MarcinWojewodzic/C7_weatherstation/README.md

# C7_weatherstation
Simple weather station with e-inc display with measurement memory based on PMS3003 and BME688 sensors
