MarcinWojewodzic/C7_weatherstation/Hardware/C7W1B1V1.0/KiCad/3D/W25N512GVEIG.stp

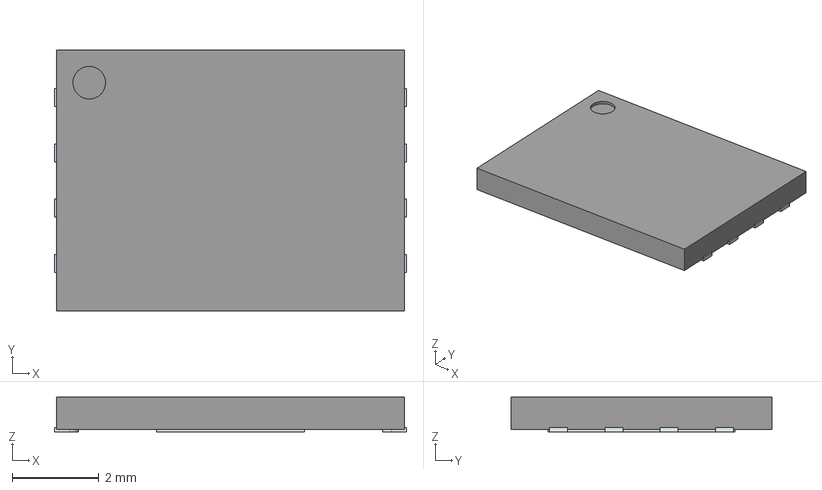
[picture p1: CAD file, 2024-11-15]
Hardware/C7W1B1V1.0/KiCad/3D/W25N512GVEIG.stp
8.10 x 6.00 x 0.8 mm
ThermalPin
PinsArrayLR
