MarcinWojewodzic/C7_weatherstation/Hardware/C7W1B1V1.0/KiCad/3D/MB85RS512TPNF-G-JNERE1.stp

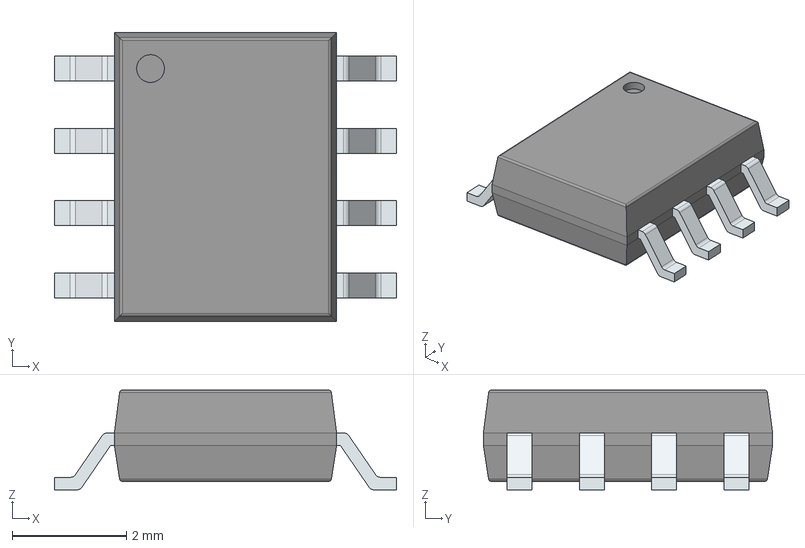
[picture p2: CAD file, 2024-11-15]
Hardware/C7W1B1V1.0/KiCad/3D/MB85RS512TPNF-G-JNERE1.stp
6.00 x 5.08 x 1.75 mm
PinsArrayLR
