MarcinWojewodzic/C7_weatherstation/Hardware/C7W1B1V1.0/KiCad/3D/STC4054GR.stp

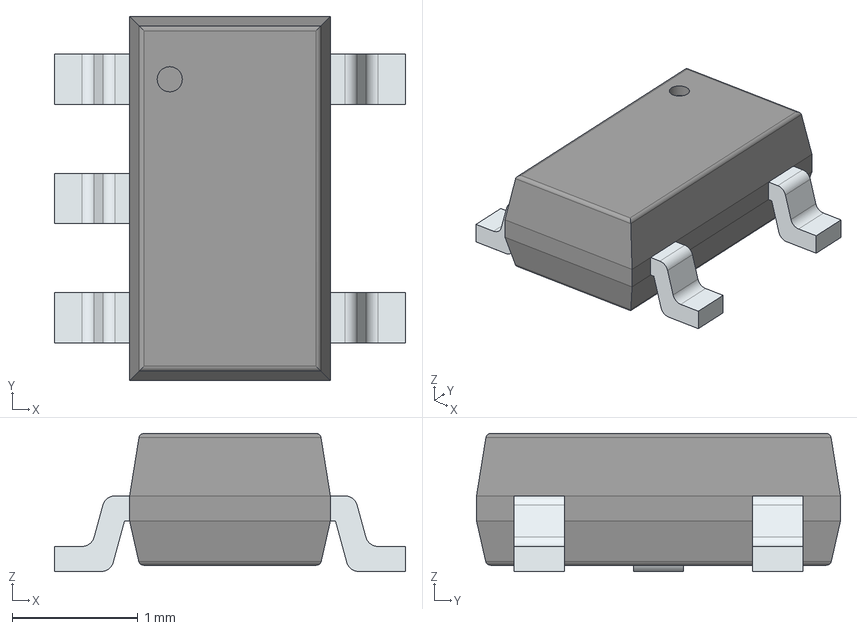
[picture p3: CAD file, 2024-11-08]
Hardware/C7W1B1V1.0/KiCad/3D/STC4054GR.stp
2.80 x 2.90 x 1.10 mm
PinsArrayL
PinsArrayR
