MarcinWojewodzic/C7_weatherstation/Hardware/C7W1B1V1.0/KiCad/3D/S-8261AAXMD-G2XT2U.stp

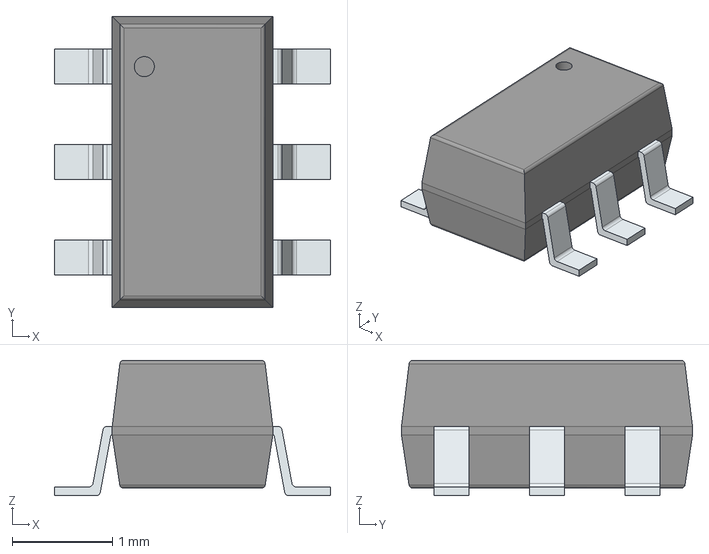
[picture p4: CAD file, 2024-11-08]
Hardware/C7W1B1V1.0/KiCad/3D/S-8261AAXMD-G2XT2U.stp
2.75 x 2.90 x 1.35 mm
PinsArrayLR
