MarcinWojewodzic/C7_weatherstation/Hardware/C7W1B1V1.0/KiCad/3D/PMDPB30XNAX.stp

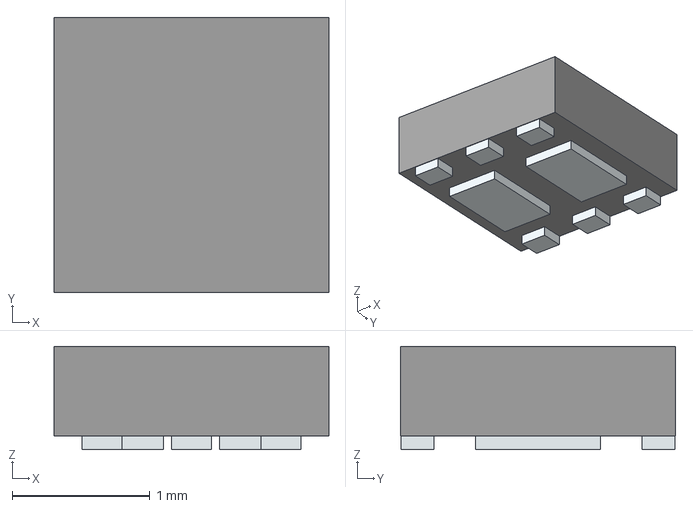
[picture p5: CAD file, 2024-11-08]
Hardware/C7W1B1V1.0/KiCad/3D/PMDPB30XNAX.stp
2.00 x 2.00 x 0.75 mm
Pins
