MarcinWojewodzic/C7_weatherstation/Hardware/C7W1B1V1.0/KiCad/3D/USBLC6-2P6.stp

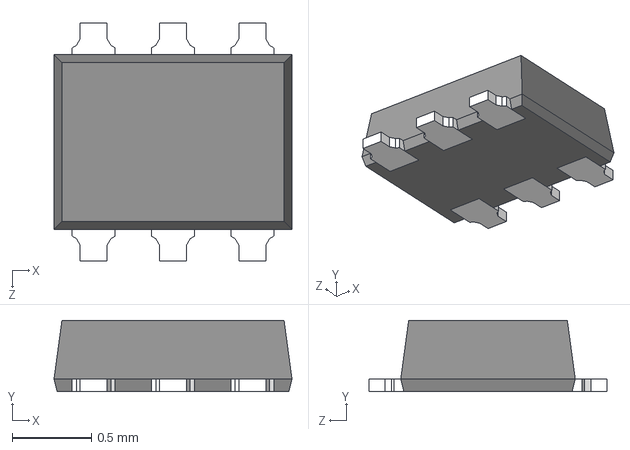
[picture p6: CAD file, 2024-11-08]
Hardware/C7W1B1V1.0/KiCad/3D/USBLC6-2P6.stp
1.50 x 0.45 x 1.50 mm
