MarcinWojewodzic/C7_weatherstation/Hardware/C7W1B1V1.0/KiCad/3D/BME688.stp

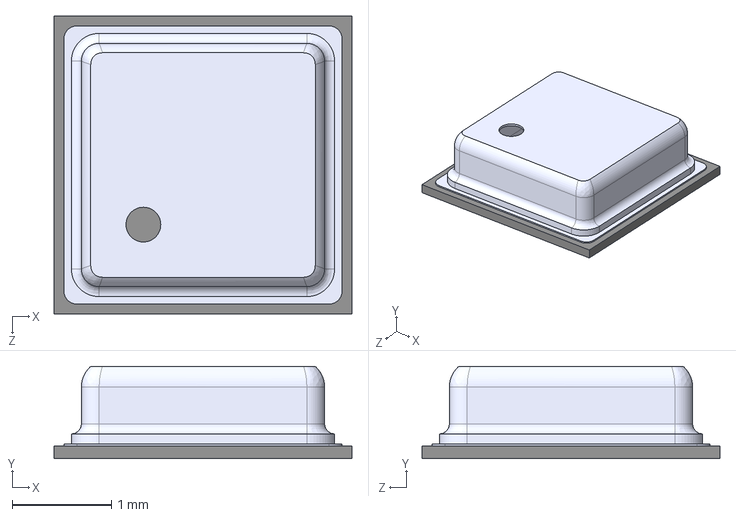
[picture p7: CAD file, 2024-11-08]
Hardware/C7W1B1V1.0/KiCad/3D/BME688.stp
3.00 x 0.93 x 3.00 mm
