MarcinWojewodzic/C7_weatherstation/Hardware/C7W1B1V1.0/KiCad/3D/USB4105GFA120.step

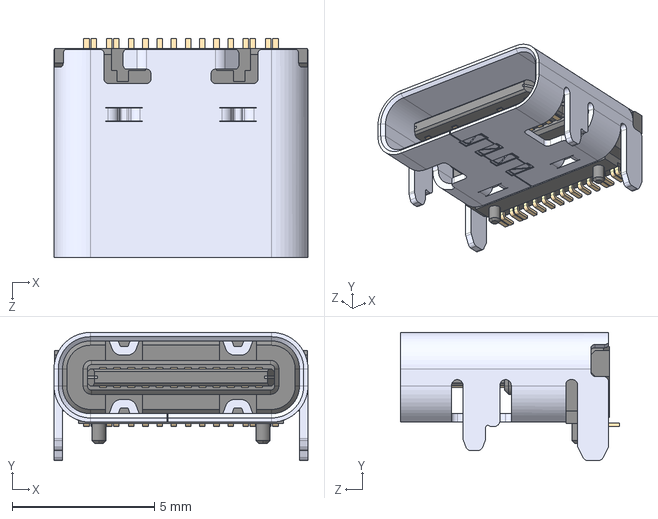
[picture p8: CAD file, 2024-11-08]
Hardware/C7W1B1V1.0/KiCad/3D/USB4105GFA120.step
8.94 x 4.51 x 7.71 mm
