MarcinWojewodzic/C7_weatherstation/Hardware/C7W1B1V1.0/KiCad/3D/LD39200PU33R.stp

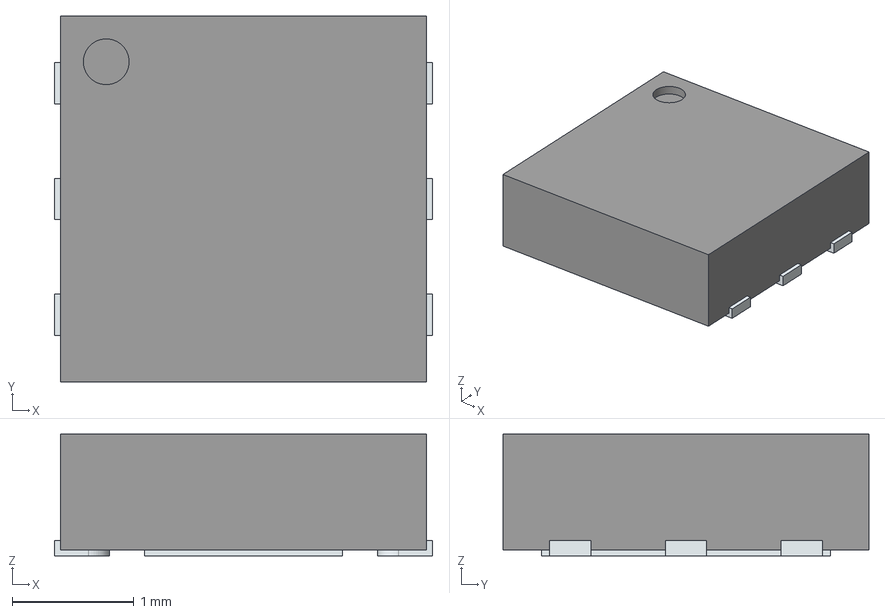
[picture p9: CAD file, 2024-11-16]
Hardware/C7W1B1V1.0/KiCad/3D/LD39200PU33R.stp
3.10 x 3.00 x 1.00 mm
ThermalPin
PinsArrayLR
