MarcinWojewodzic/C7_weatherstation/Hardware/C7W1B1V1.0/KiCad/3D/LMR62421XSD_NOPB.stp

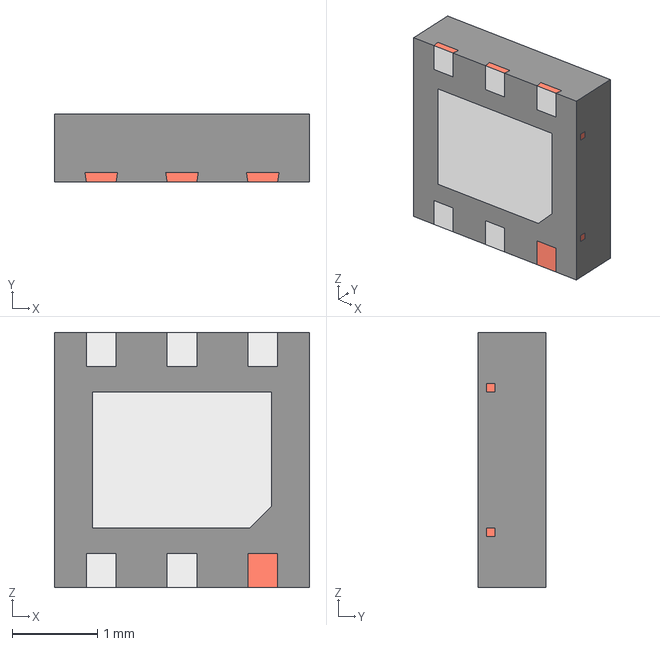
[picture p10: CAD file, 2024-11-08]
Hardware/C7W1B1V1.0/KiCad/3D/LMR62421XSD_NOPB.stp
3.00 x 0.8 x 3.00 mm
BODY_SDE06A
FRAME_SDE06A
