MarcinWojewodzic/C7_weatherstation/Hardware/C7W1B1V1.0/KiCad/C7W1B1V1.0.kicad_pcb

## KiCad design Hardware/C7W1B1V1.0/KiCad/C7W1B1V1.0.kicad_pcb (2024-11-16)

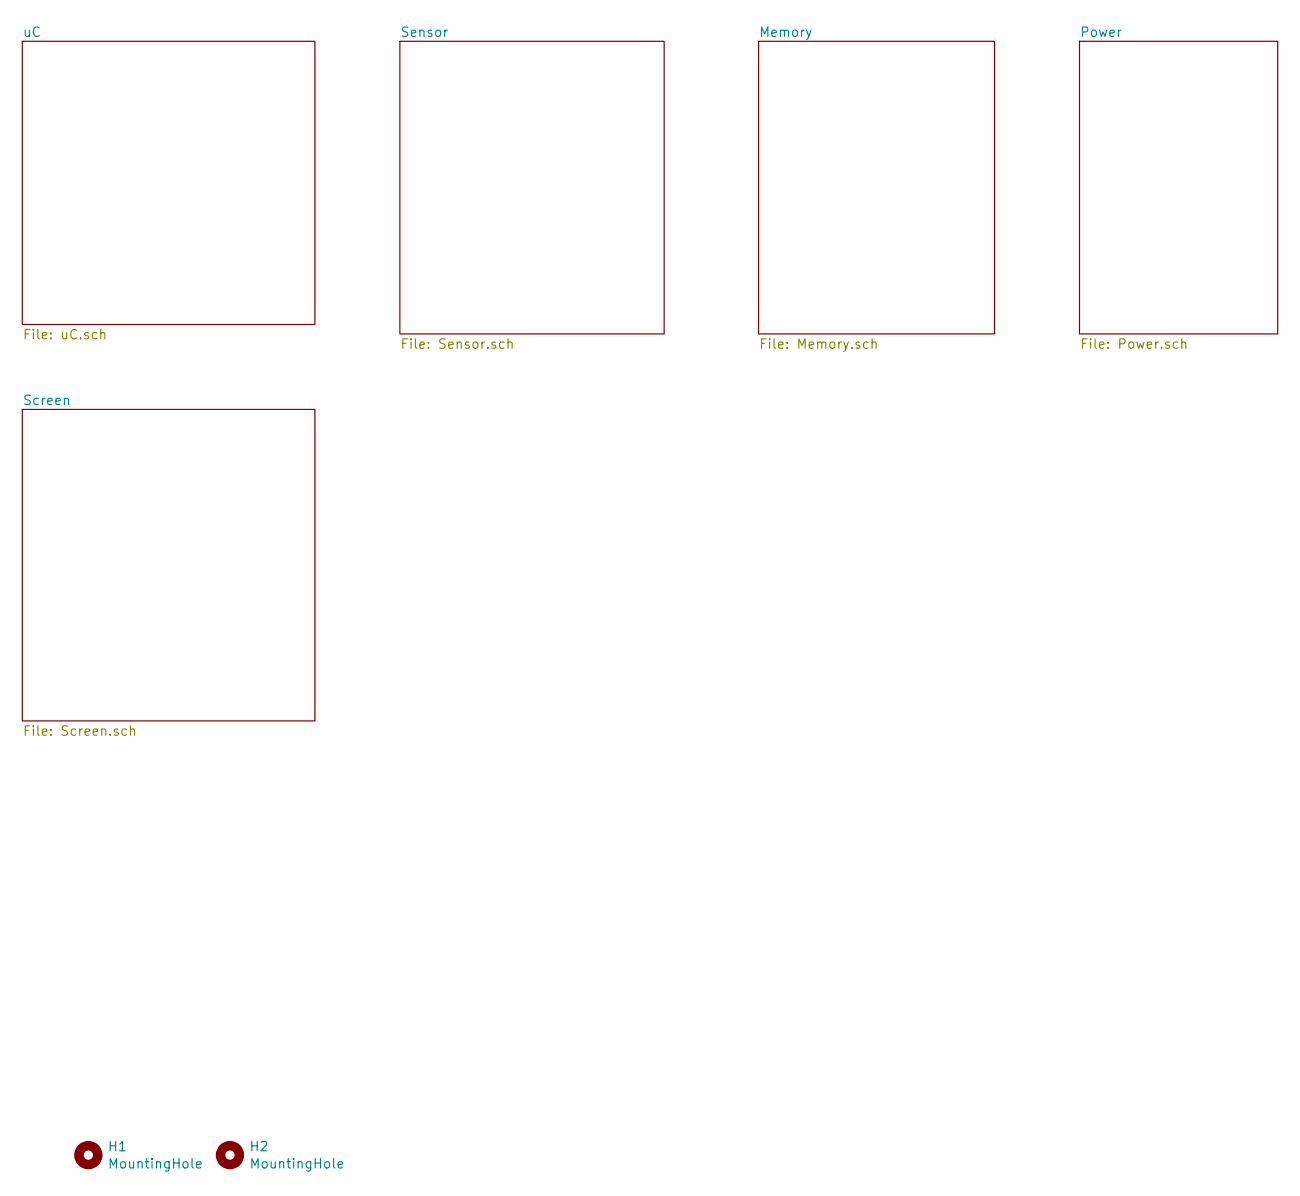
[picture p11: schematic C7W1B1V1.0.sch]

Parts:
H1, H2: MountingHole; MountingHole_2.7mm_M2.5

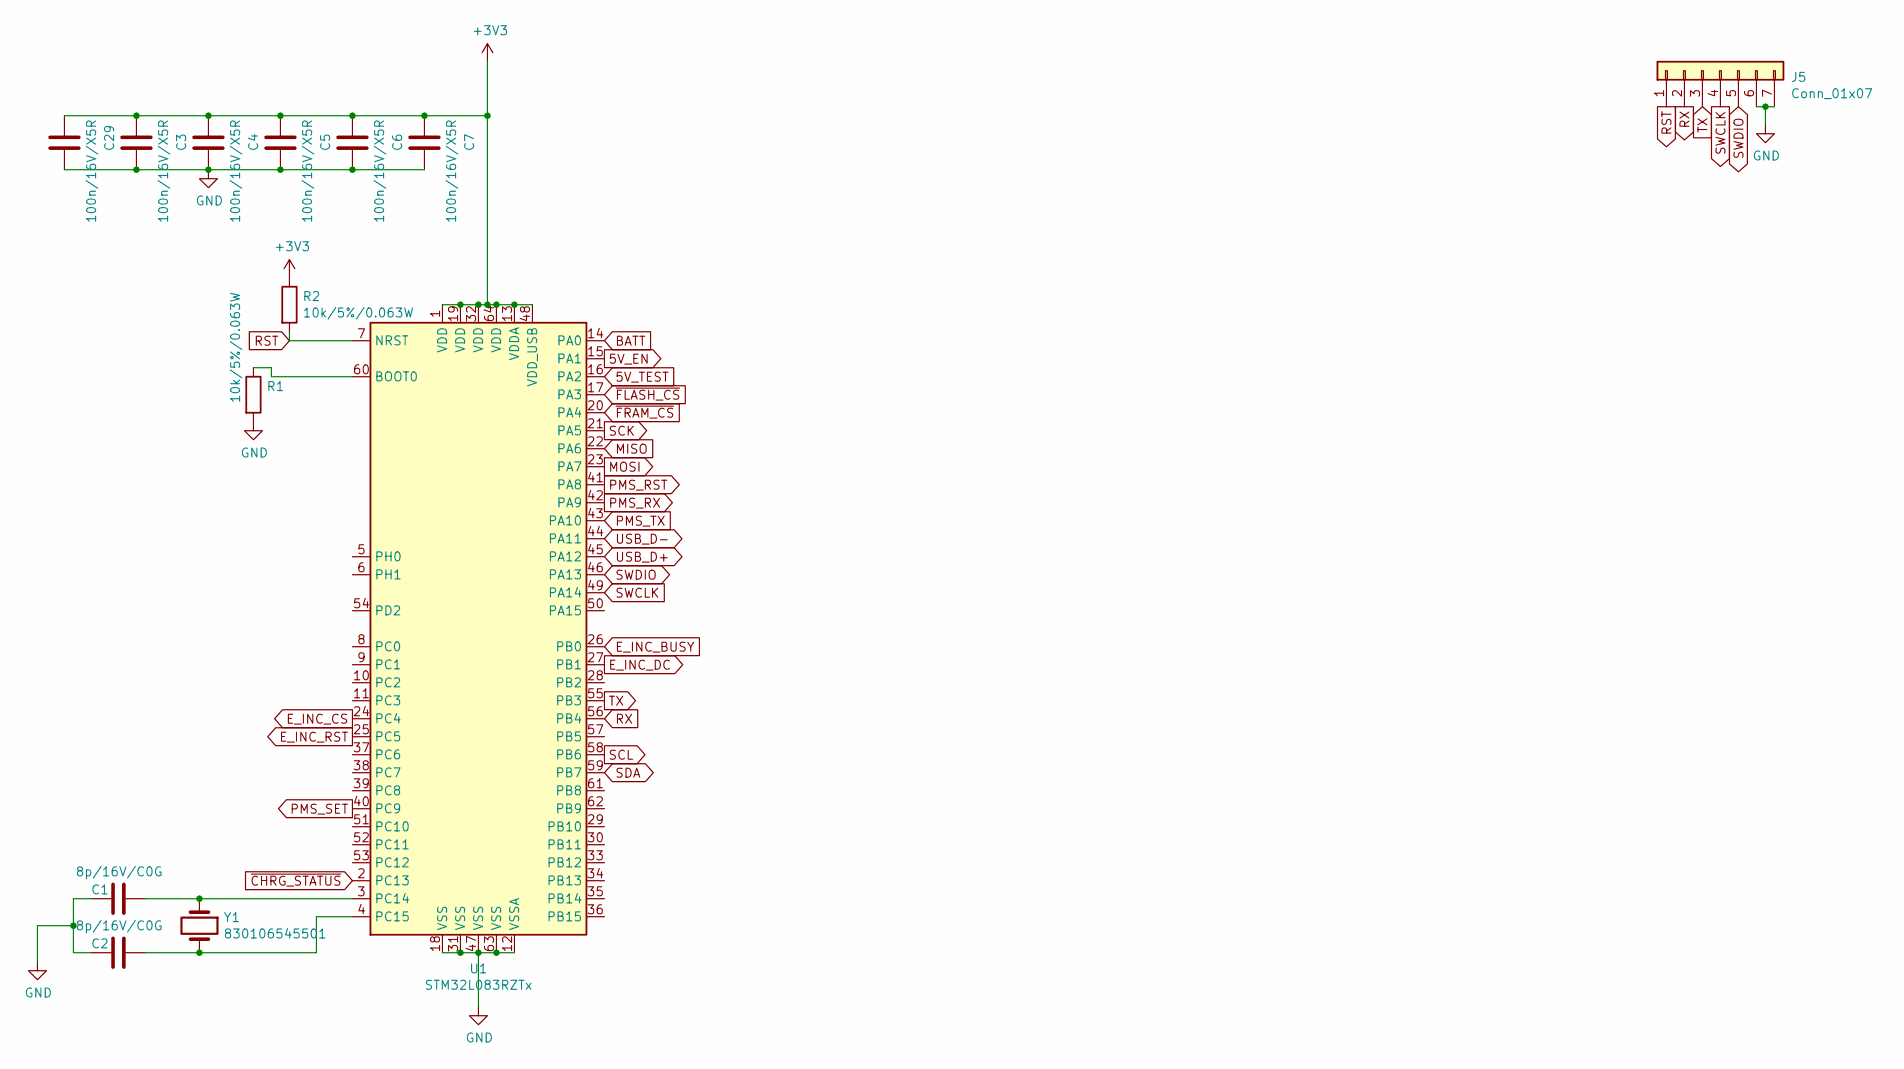
[picture p12: schematic uC.sch]

Parts:
C1, C2: 8p/16V/C0G; C_0402_1005Metric
C3, C4, C5, C6, C7, C29: 100n/16V/X5R; C_0402_1005Metric
J5: Conn_01x07; PinSocket_1x07_P2.54mm_Vertical
R1, R2: 10k/5%/0.063W; R_0402_1005Metric
U1: STM32L083RZTx; LQFP-64_10x10mm_P0.5mm
Y1: 830106545501; Crystal_SMD_2012-2Pin_2.0x1.2mm

Connections:
5V_EN: U1.15 (PA1); also elsewhere on the board
5V_TEST: U1.16 (PA2); also elsewhere on the board
+3V3: C3.1, C4.1, C5.1, C6.1, C7.1, C29.1, R2.1, U1.1 (VDD), U1.13 (VDDA), U1.19 (VDD), U1.32 (VDD), U1.48 (VDD_USB), U1.64 (VDD); also elsewhere on the board
BATT: U1.14 (PA0); also elsewhere on the board
E_INC_BUSY: U1.26 (PB0); also elsewhere on the board
E_INC_CS: U1.24 (PC4); also elsewhere on the board
E_INC_DC: U1.27 (PB1); also elsewhere on the board
E_INC_RST: U1.25 (PC5); also elsewhere on the board
GND: C1.1, C2.1, C3.2, C4.2, C5.2, C6.2, C7.2, C29.2, J5.6, J5.7, R1.2, U1.12 (VSSA), U1.18 (VSS), U1.31 (VSS), U1.47 (VSS), U1.63 (VSS); also elsewhere on the board
MISO: U1.22 (PA6); also elsewhere on the board
MOSI: U1.23 (PA7); also elsewhere on the board
unnamed: C1.2, U1.3 (PC14), Y1.1
unnamed: C2.2, U1.4 (PC15), Y1.2
unnamed: R1.1, U1.60 (BOOT0)
PMS_RST: U1.41 (PA8); also elsewhere on the board
PMS_RX: U1.42 (PA9); also elsewhere on the board
PMS_SET: U1.40 (PC9); also elsewhere on the board
PMS_TX: U1.43 (PA10); also elsewhere on the board
RST: J5.1, R2.2, U1.7 (NRST)
RX: J5.2, U1.56 (PB4)
SCK: U1.21 (PA5); also elsewhere on the board
SCL: U1.58 (PB6); also elsewhere on the board
SDA: U1.59 (PB7); also elsewhere on the board
SWCLK: J5.4, U1.49 (PA14)
SWDIO: J5.5, U1.46 (PA13)
TX: J5.3, U1.55 (PB3)
USB_D+: U1.45 (PA12); also elsewhere on the board
USB_D-: U1.44 (PA11); also elsewhere on the board
~CHRG_STATUS: U1.2 (PC13); also elsewhere on the board
~FLASH_CS: U1.17 (PA3); also elsewhere on the board
~FRAM_CS: U1.20 (PA4); also elsewhere on the board

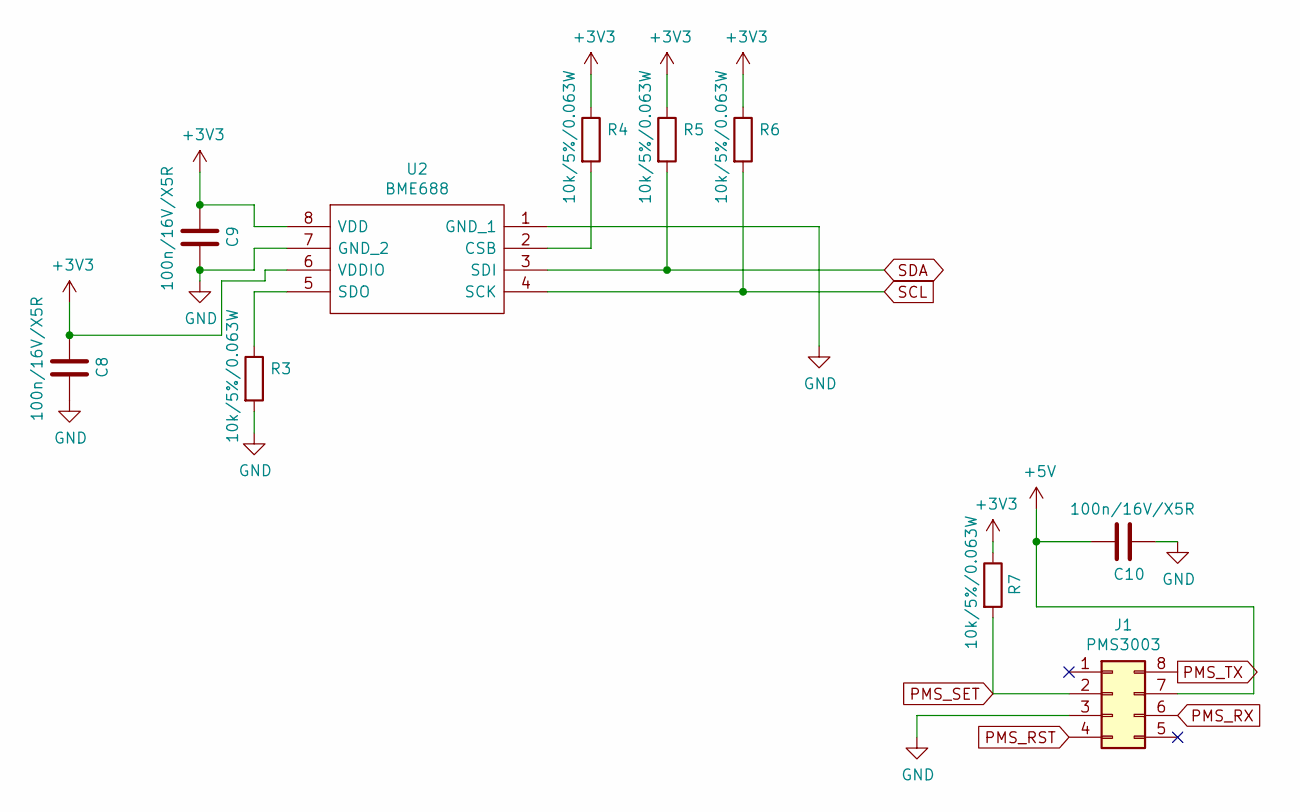
[picture p13: schematic Sensor.sch]

Parts:
C8, C9, C10: 100n/16V/X5R; C_0402_1005Metric
J1: PMS3003; PinHeader_2x04_P2.54mm_Vertical
R3, R4, R5, R6, R7: 10k/5%/0.063W; R_0402_1005Metric
U2: BME688; Manufacturer_Part_Number BME688; Mouser Part Number 262-BME688

Connections:
+3V3: C8.1, C9.1, R4.1, R5.1, R6.1, R7.1, U2.6 (VDDIO), U2.8 (VDD); also elsewhere on the board
+5V: C10.2, J1.7; also elsewhere on the board
GND: C8.2, C9.2, C10.1, J1.3, R3.2, U2.1 (GND_1), U2.7 (GND_2); also elsewhere on the board
unnamed: R3.1, U2.5 (SDO)
unnamed: R4.2, U2.2 (CSB)
PMS_RST: J1.4; also elsewhere on the board
PMS_RX: J1.6; also elsewhere on the board
PMS_SET: J1.2, R7.2; also elsewhere on the board
PMS_TX: J1.8; also elsewhere on the board
SCL: R6.2, U2.4 (SCK); also elsewhere on the board
SDA: R5.2, U2.3 (SDI); also elsewhere on the board

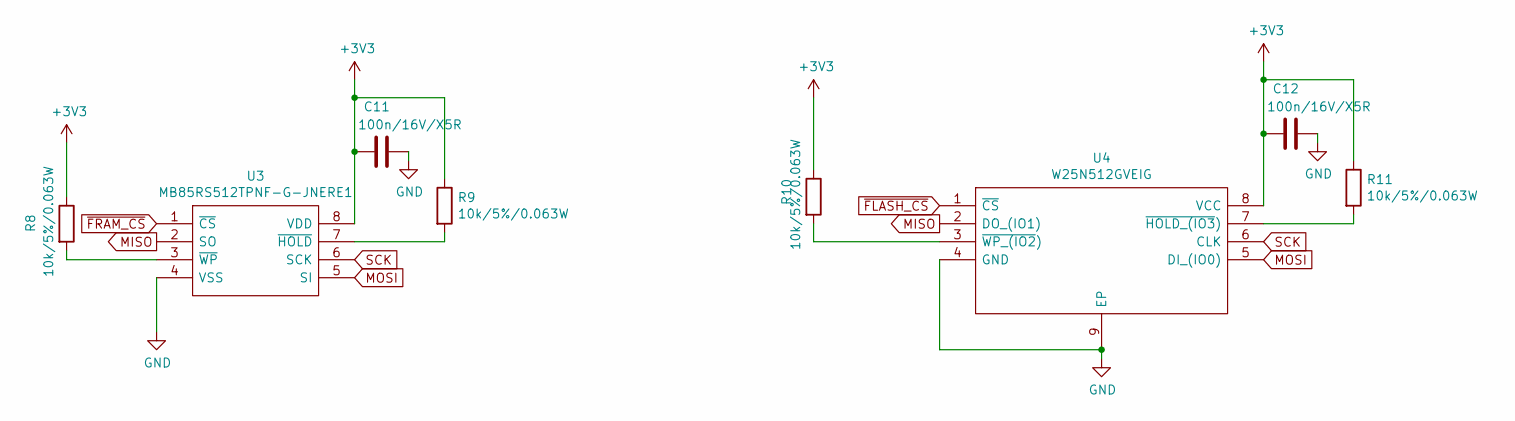
[picture p14: schematic Memory.sch]

Parts:
C11, C12: 100n/16V/X5R; C_0402_1005Metric
R8, R9, R10, R11: 10k/5%/0.063W; R_0402_1005Metric
U3: MB85RS512TPNF-G-JNERE1; SOIC127P600X175-8N; Manufacturer_Part_Number MB85RS512TPNF-G-JNERE1; Mouser Part Number 249-85S512TPNFGJNR1
U4: W25N512GVEIG; SON127P800X600X80-9N-D; Manufacturer_Part_Number W25N512GVEIG; Mouser Part Number 454-W25N512GVEIG

Connections:
+3V3: C11.1, C12.1, R8.1, R9.1, R10.1, R11.1, U3.8 (VDD), U4.8 (VCC); also elsewhere on the board
GND: C11.2, C12.2, U3.4 (VSS), U4.4 (GND), U4.9 (EP); also elsewhere on the board
MISO: U3.2 (SO), U4.2 (DO_(IO1)); also elsewhere on the board
MOSI: U3.5 (SI), U4.5 (DI_(IO0)); also elsewhere on the board
unnamed: R8.2, U3.3 (~WP)
unnamed: R9.2, U3.7 (~HOLD)
unnamed: R10.2, U4.3 (~WP_(IO2))
unnamed: R11.2, U4.7 (~HOLD_(IO3))
SCK: U3.6 (SCK), U4.6 (CLK); also elsewhere on the board
~FLASH_CS: U4.1 (~CS); also elsewhere on the board
~FRAM_CS: U3.1 (~CS); also elsewhere on the board

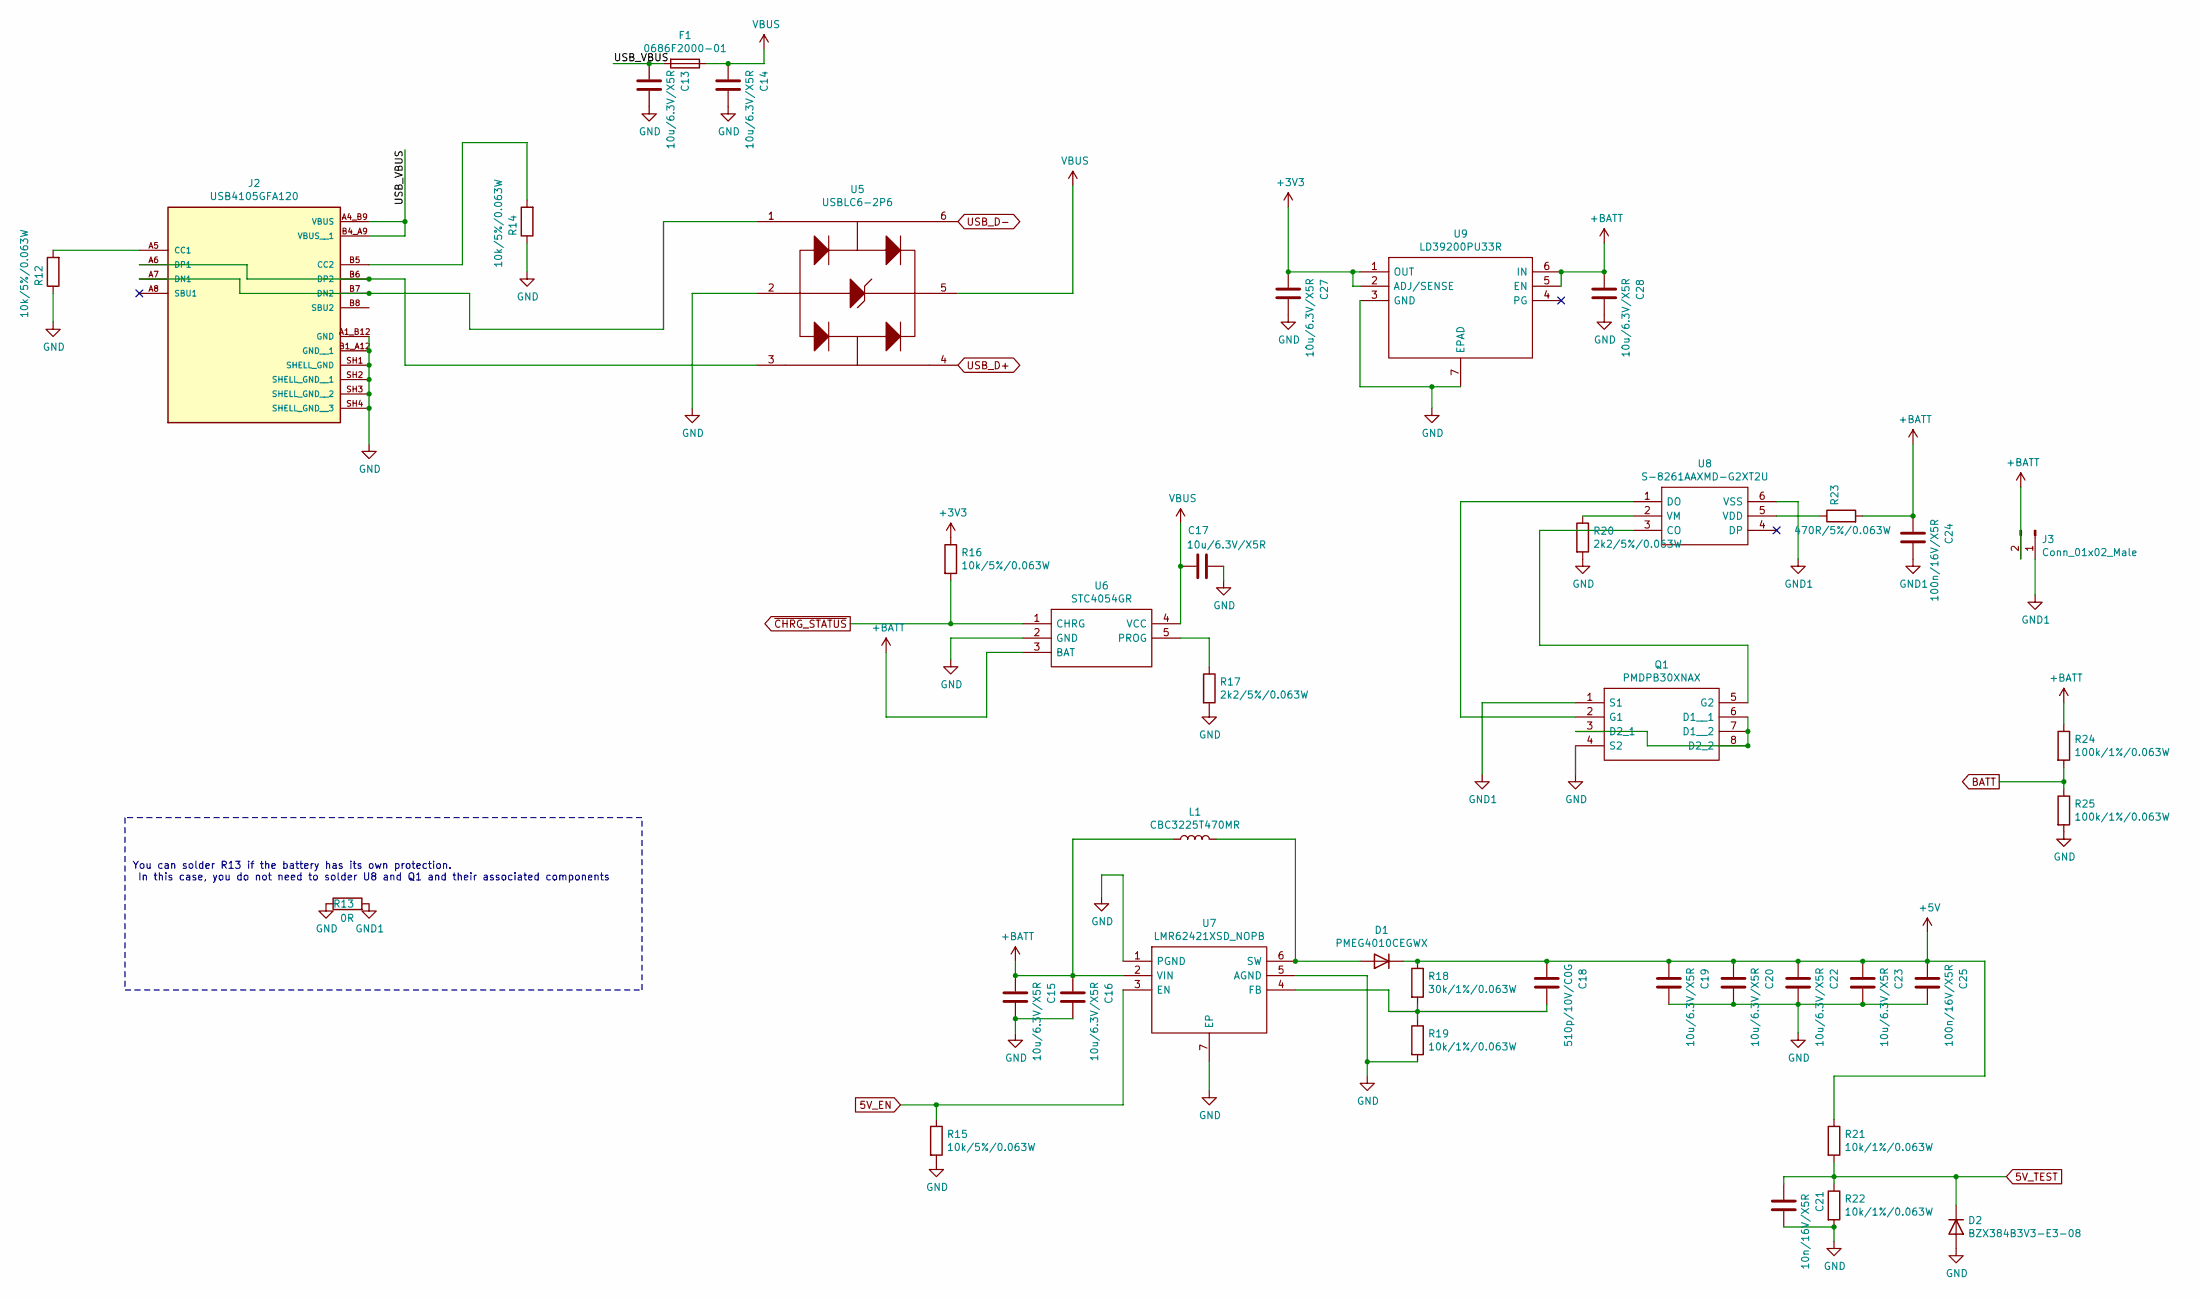
[picture p15: schematic Power.sch]

Parts:
C13, C14, C15, C16, C17, C19, C20, C22, C23, C27, C28: 10u/6.3V/X5R; C_0402_1005Metric
C18: 510p/10V/C0G; C_0402_1005Metric
C21: 10n/16V/X5R; C_0402_1005Metric
C24, C25: 100n/16V/X5R; C_0402_1005Metric
D1: PMEG4010CEGWX; D_SOD-123
D2: BZX384B3V3-E3-08; D_SOD-323
F1: 0686F2000-01; Fuse_0603_1608Metric
J2: USB4105GFA120; GCT_USB4105GFA120; PARTREV B3
J3: Conn_01x02_Male; TerminalBlock_bornier-2_P5.08mm
L1: CBC3225T470MR; L_1210_3225Metric
Q1: PMDPB30XNAX; Manufacturer_Part_Number PMDPB30XNAX; Mouser Part Number 771-PMDPB30XNAX
R12, R14, R15, R16: 10k/5%/0.063W; R_0402_1005Metric
R13: 0R; R_0402_1005Metric
R17, R20: 2k2/5%/0.063W; R_0402_1005Metric
R18: 30k/1%/0.063W; R_0402_1005Metric
R19, R21, R22: 10k/1%/0.063W; R_0402_1005Metric
R23: 470R/5%/0.063W; R_0402_1005Metric
R24, R25: 100k/1%/0.063W; R_0402_1005Metric
U5: USBLC6-2P6; USBLC62P6; Manufacturer_Part_Number USBLC6-2P6; Mouser Part Number 511-USBLC6-2P6
U6: STC4054GR; SOT95P280X110-5N; Manufacturer_Part_Number STC4054GR; Mouser Part Number 511-STC4054GR
U7: LMR62421XSD_NOPB; SON95P300X300X80-7N; Manufacturer_Part_Number LMR62421XSD/NOPB; Mouser Part Number 595-LMR62421XSD/NOPB
U8: S-8261AAXMD-G2XT2U; SOT95P275X135-6N; Manufacturer_Part_Number S-8261AAXMD-G2XT2U; Mouser Part Number 628-S8261AAXMDG2XT2G
U9: LD39200PU33R; SON95P300X300X100-7N-D; Manufacturer_Part_Number LD39200PU33R; Mouser Part Number 511-LD39200PU33R

Connections:
5V_EN: R15.1, U7.3 (EN); also elsewhere on the board
5V_TEST: C21.1, D2.1 (K), R21.2, R22.1; also elsewhere on the board
+3V3: C27.1, R16.1, U9.1 (OUT), U9.2 (ADJ/SENSE); also elsewhere on the board
+5V: C18.1, C19.1, C20.1, C22.1, C23.1, C25.1, D1.1 (K), R18.1, R21.1; also elsewhere on the board
+BATT: C15.1, C16.1, C24.1, C28.1, J3.2, L1.1, R23.2, R24.1, U6.3 (BAT), U7.2 (VIN), U9.5 (EN), U9.6 (IN)
/Power/USB_VBUS: C13.1, F1.2, J2.A4_B9 (VBUS), J2.B4_A9 (VBUS__1)
BATT: R24.2, R25.1; also elsewhere on the board
GND: C13.2, C14.2, C15.2, C16.2, C17.2, C19.2, C20.2, C21.2, C22.2, C23.2, C25.2, C27.2, C28.2, D2.2 (A), J2.A1_B12 (GND), J2.B1_A12 (GND__1), J2.SH1 (SHELL_GND), J2.SH2 (SHELL_GND__1), J2.SH3 (SHELL_GND__2), J2.SH4 (SHELL_GND__3), Q1.4 (S2), R12.1, R13.1, R14.1, R15.2, R17.2, R19.2, R20.2, R22.2, R25.2, U5.2, U6.2 (GND), U7.1 (PGND), U7.5 (AGND), U7.7 (EP), U9.3 (GND), U9.7 (EPAD); also elsewhere on the board
GND1: C24.2, J3.1, Q1.1 (S1), R13.2, U8.6 (VSS)
unnamed: C18.2, R18.2, R19.1, U7.4 (FB)
unnamed: D1.2 (A), L1.2, U7.6 (SW)
unnamed: J2.A5 (CC1), R12.2
unnamed: J2.A6 (DP1), J2.B6 (DP2), U5.3
unnamed: J2.A7 (DN1), J2.B7 (DN2), U5.1
unnamed: J2.B5 (CC2), R14.2
unnamed: Q1.2 (G1), U8.1 (DO)
unnamed: Q1.3 (D2_1), Q1.6 (D1__1), Q1.7 (D1__2), Q1.8 (D2_2)
unnamed: Q1.5 (G2), U8.3 (CO)
unnamed: R17.1, U6.5 (PROG)
unnamed: R20.1, U8.2 (VM)
unnamed: R23.1, U8.5 (VDD)
USB_D+: U5.4; also elsewhere on the board
USB_D-: U5.6; also elsewhere on the board
VBUS: C14.1, C17.1, F1.1, U5.5, U6.4 (VCC)
~CHRG_STATUS: R16.2, U6.1 (CHRG); also elsewhere on the board

Notes on the sheet:
You can solder R13 if the battery has its own protection. In this case, you do not need to solder U8 and Q1 and their associated components

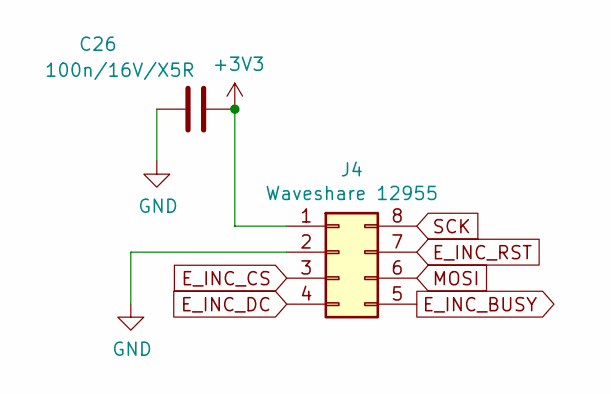
[picture p16: schematic Screen.sch]

Parts:
C26: 100n/16V/X5R; C_0402_1005Metric
J4: Waveshare 12955; PinHeader_2x04_P2.54mm_Vertical

Connections:
+3V3: C26.2, J4.1; also elsewhere on the board
E_INC_BUSY: J4.5; also elsewhere on the board
E_INC_CS: J4.3; also elsewhere on the board
E_INC_DC: J4.4; also elsewhere on the board
E_INC_RST: J4.7; also elsewhere on the board
GND: C26.1, J4.2; also elsewhere on the board
MOSI: J4.6; also elsewhere on the board
SCK: J4.8; also elsewhere on the board

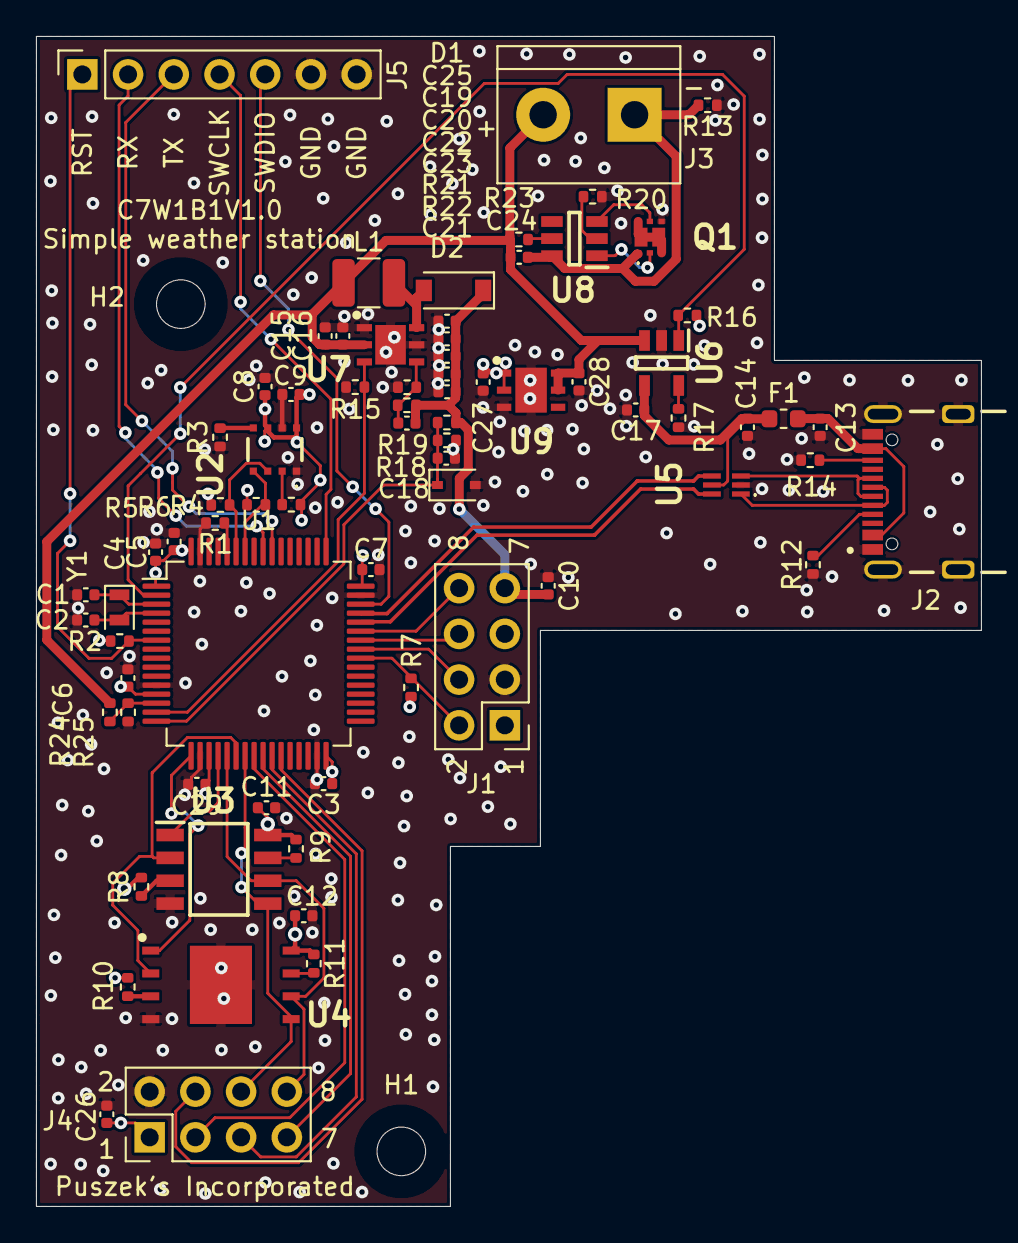
[picture p17: board C7W1B1V1.0.kicad_pcb from above]

Board: 4 copper layers, 52.5 x 65.0 mm, 76 parts (0 on the bottom side), 54 nets.
