MarcinWojewodzic/C7_weatherstation/(commit log)

2024-11-08 początkowy schemat
    [C7W1B1V1.0.kicad_pcb, C7W1B1V1.0.sch, LMR62421XSD_NOPB.stp, Memory.sch, PMDPB30XNAX.stp, Power.sch, S-8261AAXMD-G2XT2U.stp, STC4054GR.stp]
2024-11-15 Dodano projekt Cube
    [C7W1B1V1.0.kicad_pcb, MB85RS512TPNF-G-JNERE1.stp, Memory.sch, Power.sch, Screen.sch, Sensor.sch, W25N512GVEIG.stp, uC.sch]
2024-11-16 Ukończono PCB. dodano pliki produkcyjne
    [C7W1B1V1.0-B_Cu.gbl, C7W1B1V1.0-B_Mask.gbs, C7W1B1V1.0-B_Paste.gbp, C7W1B1V1.0-B_SilkS.gbo, C7W1B1V1.0-Edge_Cuts.gm1, C7W1B1V1.0-F_Cu.gtl, C7W1B1V1.0-F_Mask.gts, C7W1B1V1.0-F_Paste.gtp]
2024-11-16 Zmieniono procesor na wersję LQFP-64
    [C7W1B1V1.0-B_Cu.gbl, C7W1B1V1.0-B_Mask.gbs, C7W1B1V1.0-B_Paste.gbp, C7W1B1V1.0-B_SilkS.gbo, C7W1B1V1.0-Edge_Cuts.gm1, C7W1B1V1.0-F_Cu.gtl, C7W1B1V1.0-F_Mask.gts, C7W1B1V1.0-F_Paste.gtp]
